jonnydyer/rotator_pcb/involute_gear_symmetric_final.png

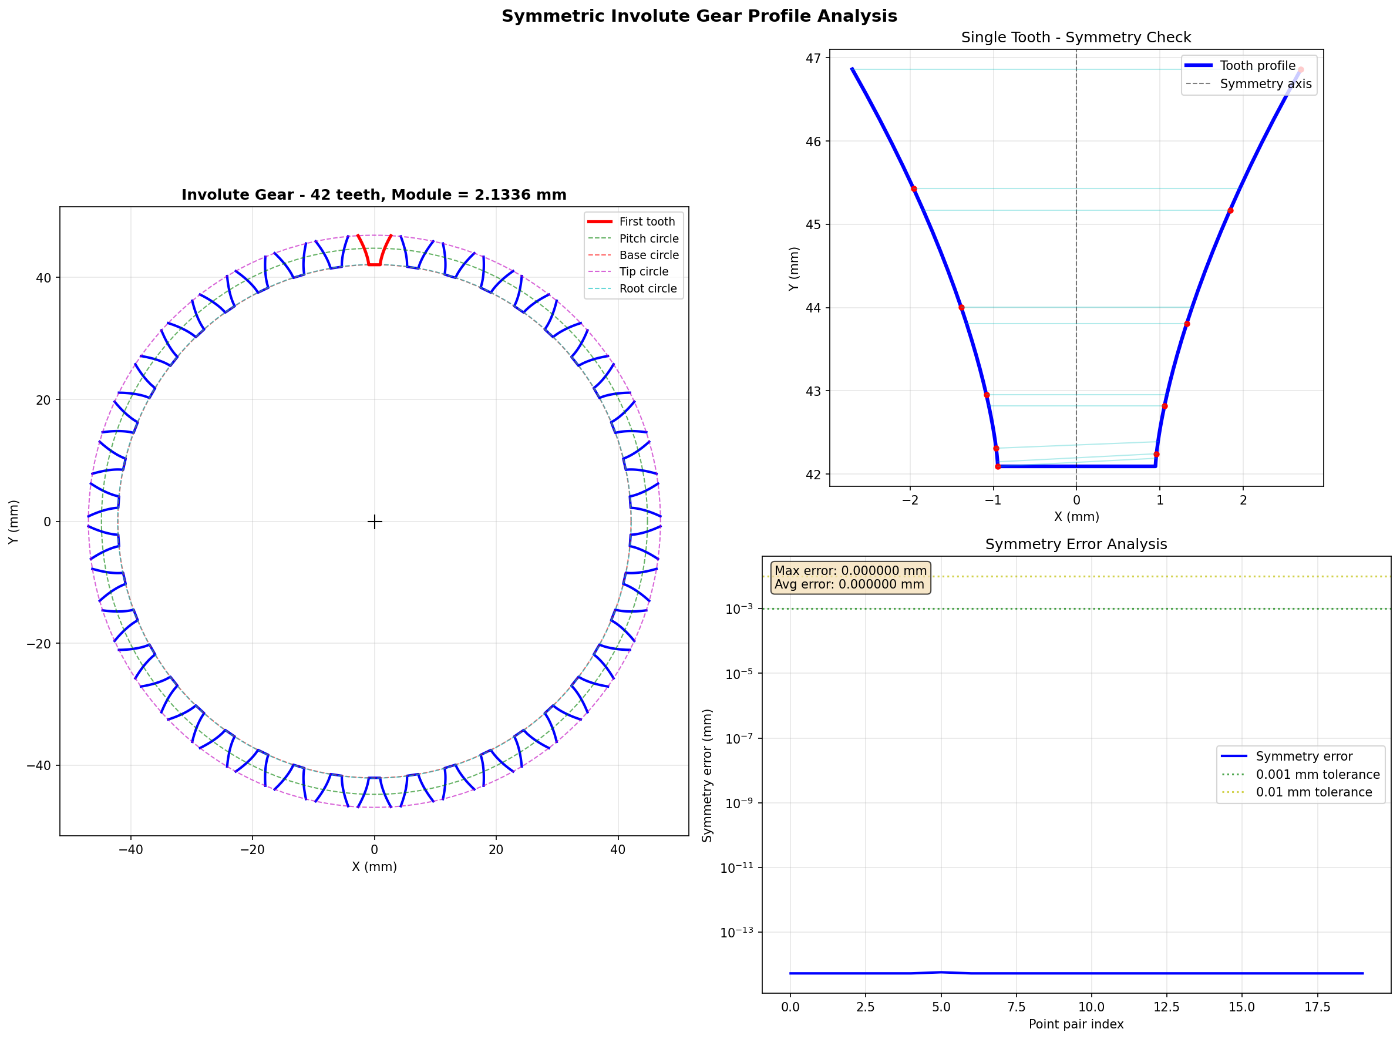
involute_gear_symmetric_final.png
