jonnydyer/rotator_pcb/kicad/four_way_rotator.kicad_pcb

## KiCad design kicad/four_way_rotator.kicad_pcb (2025-03-29)

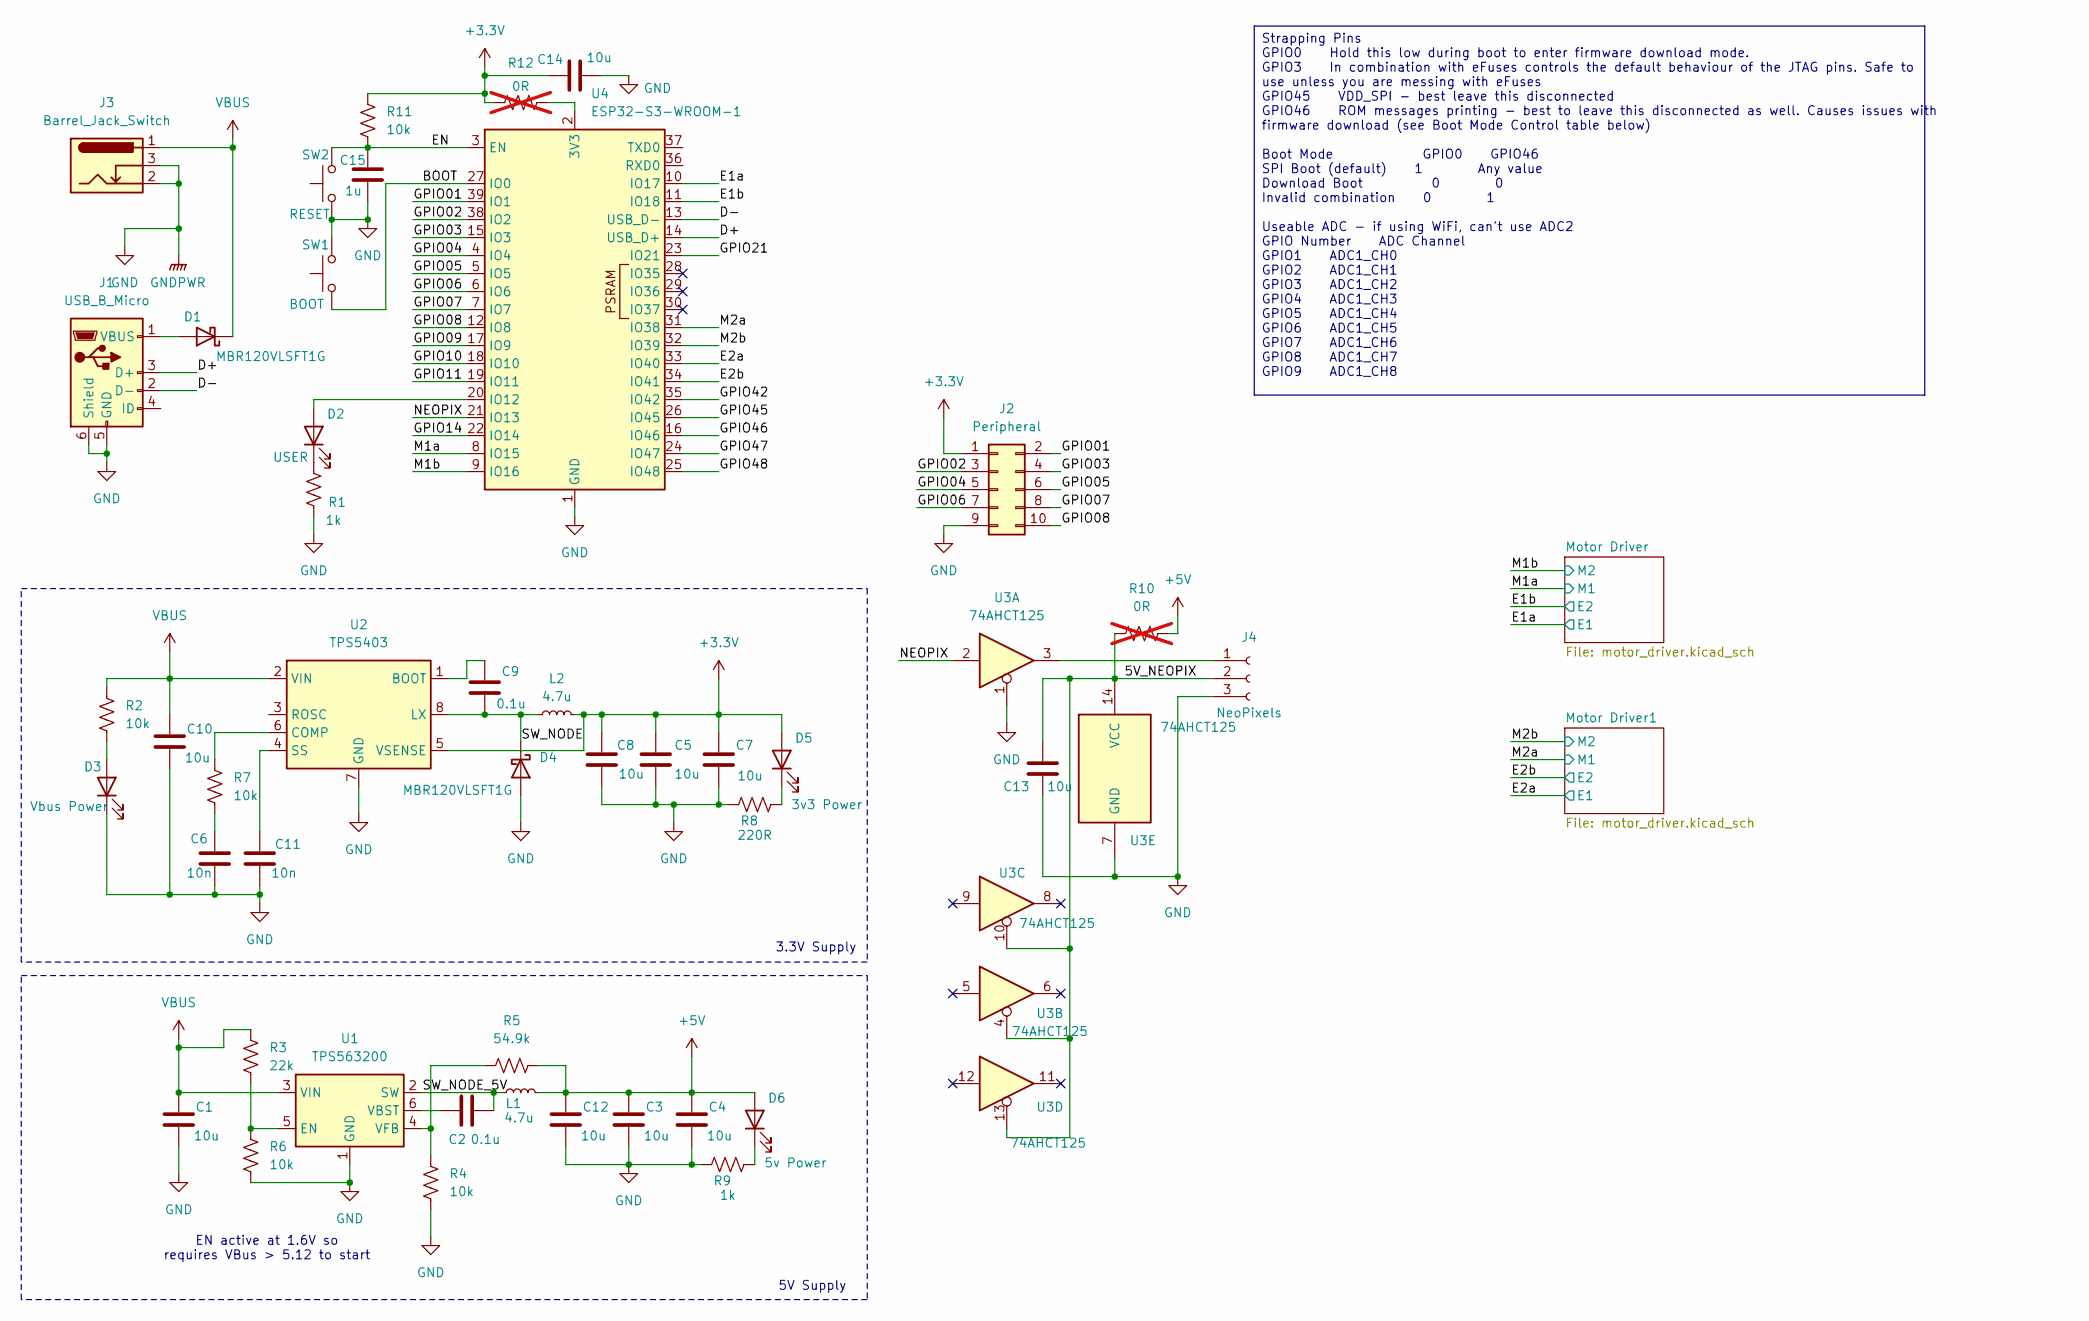
[picture p2: schematic four_way_rotator.kicad_sch]

Parts:
C1, C3, C4, C5, C7, C8, C10, C12, C13, C14: 10u; C_1206_3216Metric_Pad1.33x1.80mm_HandSolder; Mouser PN 187-CL31A106MBHNNNE
C2, C9: 0.1u; C_0603_1608Metric_Pad1.08x0.95mm_HandSolder; Mfr PN CL10A104KA8NNNC
C6: 10n; C_0603_1608Metric_Pad1.08x0.95mm_HandSolder; Mfr PN CL10B103KC8NNNC; Mouser PN 187-CL10B103KC8NNNC
C11: 10n; C_0603_1608Metric_Pad1.08x0.95mm_HandSolder; Mouser PN 187-CL10B103KC8NNNC
C15: 1u; C_0805_2012Metric_Pad1.18x1.45mm_HandSolder; Mouser PN 187-CL21B105KBFNNNE
D1, D4: MBR120VLSFT1G; D_SOD-123F; Mfr PN MBR120VLSFT1G
D2: USER; LED_0805_2012Metric_Pad1.15x1.40mm_HandSolder; Mfr PN 150080BS75000; Mouser PN 710-150080BS75000
D3: Vbus Power; LED_0805_2012Metric_Pad1.15x1.40mm_HandSolder; Mfr PN 5975906507F
D5: 3v3 Power; LED_0805_2012Metric_Pad1.15x1.40mm_HandSolder; Mfr PN 150080RS75000; Mouser PN 710-150080RS75000
D6: 5v Power; LED_0805_2012Metric_Pad1.15x1.40mm_HandSolder; Mfr PN HSMA-C190
J1: USB_B_Micro; USB_Micro-B_Molex-105017-0001; Mfr PN 105017-0001; Mouser PN 538-105017-0001
J2: Peripheral; PinHeader_2x05_P2.54mm_Vertical_SMD
J3: Barrel_Jack_Switch; BarrelJack_Wuerth_6941xx301002; Mouser PN 710-694106301002
J4: NeoPixels; Molex_Micro-Fit_3.0_43650-0300_1x03_P3.00mm_Horizontal; Mfr PN 43650-0300; Mouser PN 538-43650-0300
L1, L2: 4.7u; L_TDK_SLF6025; Mouser PN 810-CLF6045NIT4R7ND
R1, R9: 1k; R_0603_1608Metric_Pad0.98x0.95mm_HandSolder; Mfr PN CQ03SAF1001T5E; Mouser PN 303-CQ03SAF1001T5E
R2, R4, R6, R7, R11: 10k; R_0603_1608Metric_Pad0.98x0.95mm_HandSolder; Mfr PN CQ03WAF1002T5E; Mouser PN 303-CQ03WAF1002T5E
R3: 22k; R_0603_1608Metric_Pad0.98x0.95mm_HandSolder; Mfr PN 0603WAF2202T5E; Mouser PN 303-0603WAF2202T5E
R5: 54.9k; R_0603_1608Metric_Pad0.98x0.95mm_HandSolder; Mfr PN RT0603FRE0754K9L; Mouser PN 603-RT0603FRE0754K9L
R8: 220R; R_0603_1608Metric_Pad0.98x0.95mm_HandSolder; Mfr PN CQ03WAF2200T5E; Mouser PN 303-CQ03WAF2200T5E
R10, R12: 0R; R_0402_1005Metric_Pad0.72x0.64mm_HandSolder; Mfr PN RMCF0402ZT0R00; not fitted
SW1: BOOT; SW_SPST_Omron_B3FS-101xP; Mfr PN B3FS-1015; Mouser PN 653-B3FS1015
SW2: RESET; SW_SPST_Omron_B3FS-101xP; Mfr PN B3FS-1015; Mouser PN 653-B3FS1015
U1: TPS563200; SOT-23-6; Mouser PN 595-TPS563200DDCT
U2: TPS5403; SOIC-8_3.9x4.9mm_P1.27mm; Mouser PN 595-TPS5403DR
U3: 74AHCT125; SSOP-14_5.3x6.2mm_P0.65mm; Mfr PN SN74AHCT125DBR; Mouser PN 595-SN74AHCT125DBR
U4: ESP32-S3-WROOM-1; Mouser PN 356-ESP32S3WM1UN16R8

Connections:
+3.3V: C5.1, C7.1, C8.1, C14.1, D5.2 (A), J2.1, L2.2, R11.1, R12.2, U2.5 (VSENSE); also elsewhere on the board
+5V: C3.1, C4.1, C12.1, D6.2 (A), L1.2, R5.2, R10.1
/5V_NEOPIX: C13.2, J4.2, R10.2, U3.4, U3.10, U3.13, U3.14 (VCC)
/BOOT: SW1.1, U4.27 (IO0)
/D+: J1.3 (D+), U4.14 (USB_D+)
/D-: J1.2 (D-), U4.13 (USB_D-)
/E1a: U4.10 (IO17); also elsewhere on the board
/E1b: U4.11 (IO18); also elsewhere on the board
/E2a: U4.33 (IO40); also elsewhere on the board
/E2b: U4.34 (IO41); also elsewhere on the board
/EN: C15.1, R11.2, SW2.2, U4.3 (EN)
/GPIO01: J2.2, U4.39 (IO1)
/GPIO02: J2.3, U4.38 (IO2)
/GPIO03: J2.4, U4.15 (IO3)
/GPIO04: J2.5, U4.4 (IO4)
/GPIO05: J2.6, U4.5 (IO5)
/GPIO06: J2.7, U4.6 (IO6)
/GPIO07: J2.8, U4.7 (IO7)
/GPIO08: J2.10, U4.12 (IO8)
/GPIO09: U4.17 (IO9)
/GPIO10: U4.18 (IO10)
/GPIO11: U4.19 (IO11)
/GPIO14: U4.22 (IO14)
/GPIO21: U4.23 (IO21)
/GPIO42: U4.35 (IO42)
/GPIO45: U4.26 (IO45)
/GPIO46: U4.16 (IO46)
/GPIO47: U4.24 (IO47)
/GPIO48: U4.25 (IO48)
/M1a: U4.8 (IO15); also elsewhere on the board
/M1b: U4.9 (IO16); also elsewhere on the board
/M2a: U4.31 (IO38); also elsewhere on the board
/M2b: U4.32 (IO39); also elsewhere on the board
/NEOPIX: U3.2, U4.21 (IO13)
/SW_NODE: C9.2, D4.1 (K), L2.1, U2.8 (LX)
/SW_NODE_5V: C2.2, L1.1, U1.2 (SW)
GND: C1.2, C3.2, C4.2, C5.2, C6.2, C7.2, C8.2, C10.2, C11.2, C12.2, C13.1, C14.2, C15.2, D3.1 (K), D4.2 (A), J1.5 (GND), J1.6 (Shield), J2.9, J3.2, J3.3, J4.3, R1.1, R4.2, R6.2, R8.1, R9.1, SW1.2, SW2.1, U1.1 (GND), U2.7 (GND), U3.1, U3.7 (GND), U4.1 (GND), U4.40 (GND), U4.41 (GND); also elsewhere on the board
unnamed: C6.1, R7.2
unnamed: D1.2 (A), J1.1 (VBUS)
unnamed: D2.2 (A), U4.20 (IO12)
unnamed: D2.1 (K), R1.2
unnamed: D3.2 (A), R2.2
unnamed: D5.1 (K), R8.2
unnamed: D6.1 (K), R9.2
unnamed: J4.1, U3.3
unnamed: R3.2, R6.1, U1.5 (EN)
unnamed: C2.1, U1.6 (VBST)
unnamed: R4.1, R5.1, U1.4 (VFB)
unnamed: C9.1, U2.1 (BOOT)
unnamed: R7.1, U2.6 (COMP)
unnamed: C11.1, U2.4 (SS)
unnamed: R12.1, U4.2 (3V3)
VBUS: C1.1, C10.1, D1.1 (K), J3.1, R2.1, R3.1, U1.3 (VIN), U2.2 (VIN); also elsewhere on the board

Notes on the sheet:
5V Supply
EN active at 1.6V so requires VBus > 5.12 to start
3.3V Supply
Strapping Pins GPIO0 Hold this low during boot to enter firmware download mode. GPIO3 In combination with eFuses controls the default behaviour of the JTAG pins. Safe to use unless you are messing with eFuses GPIO45 VDD_SPI - best leave this disconnected GPIO46 ROM messages printing - best to leave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

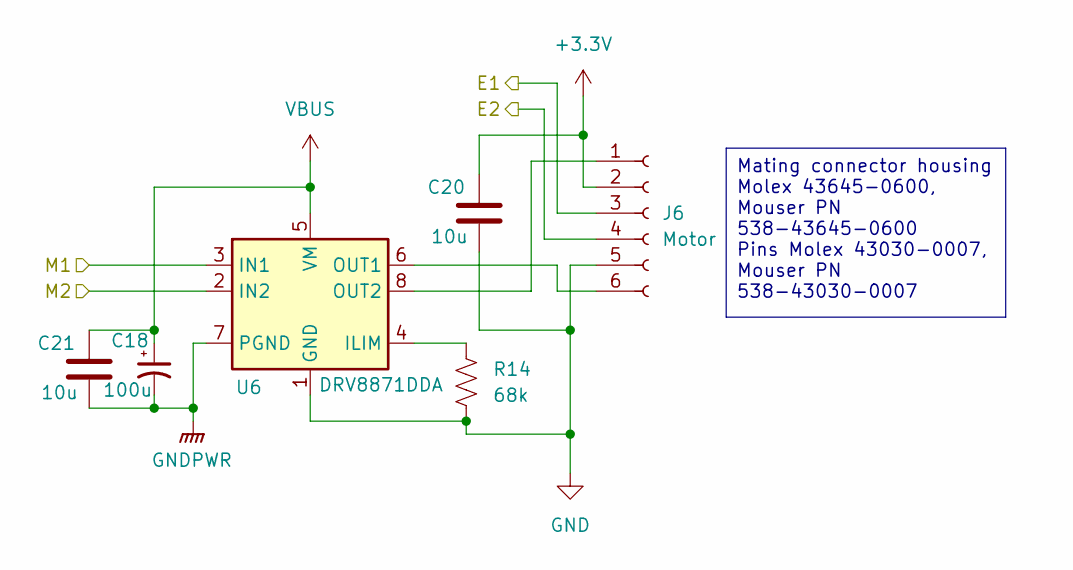
[picture p3: schematic motor_driver.kicad_sch]

Parts:
C18: 100u; CP_Elec_6.3x7.7; Mfr PN UWT1V101MCL1GS; Mouser PN 647-UWT1V101MCL1S
C20, C21: 10u; C_1206_3216Metric_Pad1.33x1.80mm_HandSolder; Mouser PN 187-CL31A106MBHNNNE
J6: Motor; Molex_Micro-Fit_3.0_43650-0600_1x06_P3.00mm_Horizontal; Mouser PN 538-43650-0600
R14: 68k; R_0603_1608Metric_Pad0.98x0.95mm_HandSolder; Mfr PN 0603WAF6802T5E; Mouser PN 303-0603WAF6802T5E
U6: DRV8871DDA; Texas_HTSOP-8-1EP_3.9x4.9mm_P1.27mm_EP2.95x4.9mm_Mask2.4x3.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; Mfr PN DRV8871DDAR; Mouser PN 595-DRV8871DDAR

Connections:
+3.3V: C20.2, J6.2; also elsewhere on the board
/E1a: J6.3; also elsewhere on the board
/E1b: J6.4; also elsewhere on the board
/M1a: U6.3 (IN1); also elsewhere on the board
/M1b: U6.2 (IN2); also elsewhere on the board
GND: C18.2, C20.1, C21.1, J6.5, R14.2, U6.1 (GND), U6.7 (GND), U6.9 (GND); also elsewhere on the board
unnamed: J6.1, U6.8 (OUT2)
unnamed: J6.6, U6.6 (OUT1)
unnamed: R14.1, U6.4 (ILIM)
VBUS: C18.1, C21.2, U6.5 (VM); also elsewhere on the board

Parts of its further copies:
C16: 100u; CP_Elec_6.3x7.7; Mfr PN UWT1V101MCL1GS; Mouser PN 647-UWT1V101MCL1S
C17, C19: 10u; C_1206_3216Metric_Pad1.33x1.80mm_HandSolder; Mouser PN 187-CL31A106MBHNNNE
J5: Motor; Molex_Micro-Fit_3.0_43650-0600_1x06_P3.00mm_Horizontal; Mouser PN 538-43650-0600
R13: 68k; R_0603_1608Metric_Pad0.98x0.95mm_HandSolder; Mfr PN 0603WAF6802T5E; Mouser PN 303-0603WAF6802T5E
U5: DRV8871DDA; Texas_HTSOP-8-1EP_3.9x4.9mm_P1.27mm_EP2.95x4.9mm_Mask2.4x3.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; Mfr PN DRV8871DDAR; Mouser PN 595-DRV8871DDAR

Connections of its further copies:
+3.3V: C19.2, J5.2; also elsewhere on the board
/E2a: J5.3; also elsewhere on the board
/E2b: J5.4; also elsewhere on the board
/M2a: U5.3 (IN1); also elsewhere on the board
/M2b: U5.2 (IN2); also elsewhere on the board
GND: C16.2, C17.1, C19.1, J5.5, R13.2, U5.1 (GND), U5.7 (GND), U5.9 (GND); also elsewhere on the board
unnamed: J5.1, U5.8 (OUT2)
unnamed: J5.6, U5.6 (OUT1)
unnamed: R13.1, U5.4 (ILIM)
VBUS: C16.1, C17.2, U5.5 (VM); also elsewhere on the board

Notes on the sheet:
Mating connector housing Molex 43645-0600, Mouser PN 538-43645-0600 Pins Molex 43030-0007, Mouser PN 538-43030-0007

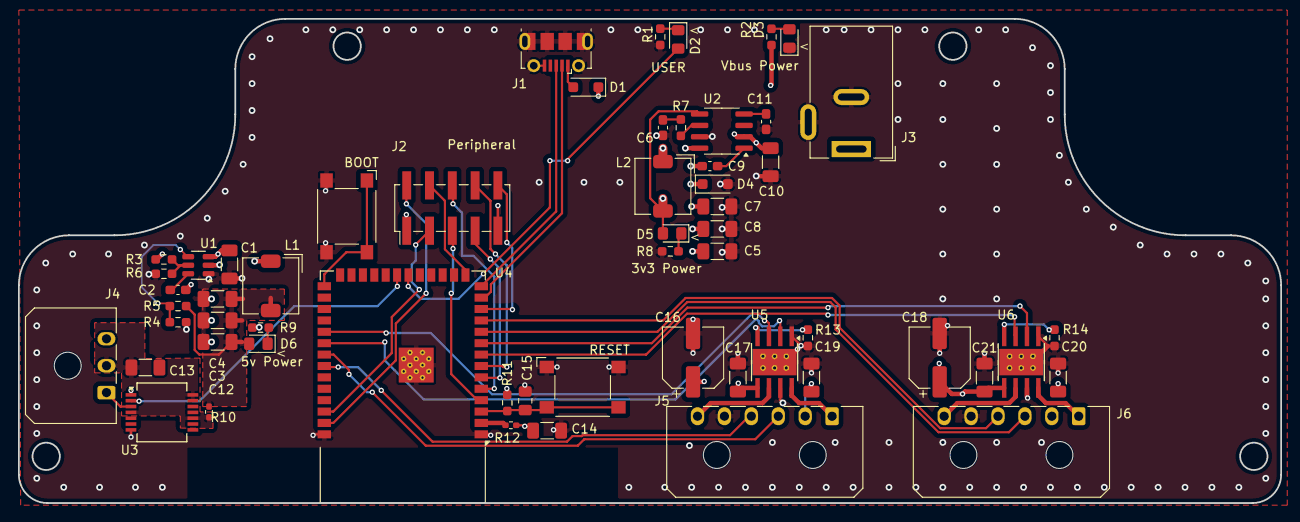
[picture p4: board four_way_rotator.kicad_pcb from above]

Board: 4 copper layers, 140.7 x 54.0 mm, 57 parts (0 on the bottom side), 49 nets.
