jonnydyer/rotator_pcb/(commit log)

2025-03-22 initial add
    [four_way_rotator-B_Cu.gbr, four_way_rotator-B_Mask.gbr, four_way_rotator-B_Paste.gbr, four_way_rotator-B_Silkscreen.gbr, four_way_rotator-Edge_Cuts.gbr, four_way_rotator-F_Cu.gbr, four_way_rotator-F_Mask.gbr, four_way_rotator-F_Paste.gbr]
2025-03-29 Fixed feedback node routing
    [four_way_rotator.kicad_pcb]
2025-07-18 Latest working rotator firmware
    [partitions.csv]
2025-10-05 a bunch of fixes
    [config.cpp, config.h, main.cpp, rotator.cpp, wifi_manager.cpp]
2025-10-11 Added not about belt circumference ot README
2025-12-25 complete rework of angle mapping to fix 360 rotation bug
    [config.cpp, config.h, generate_build_info.py, main.cpp, main.h, rotator.cpp, rotator.h]
2025-12-25 Added involute gear
